Blinkinlabs/HopeBadge/README.md

# HOPE Badge
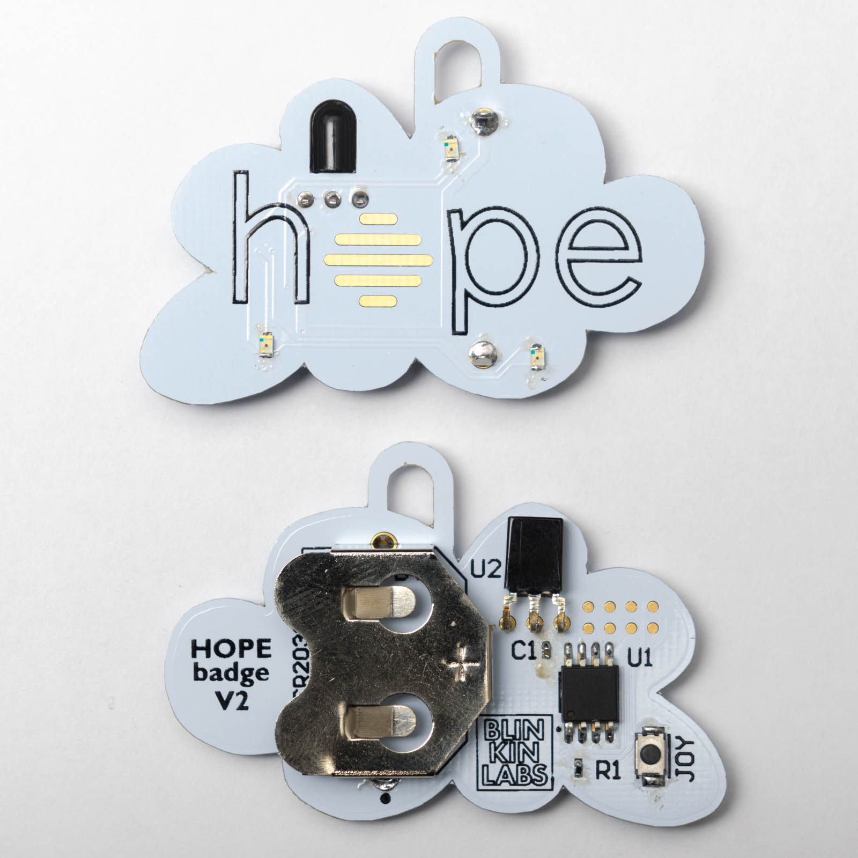
[picture p1: documentation/blinky.jpg]


HOPE Badge, Copyright 2017 Blinkinlabs, LLC

# License

This badge design is proprietary, contact us for usage.
