Blinkinlabs/HopeBadge/releases/2017-06-02 HopeBadge RevC.step

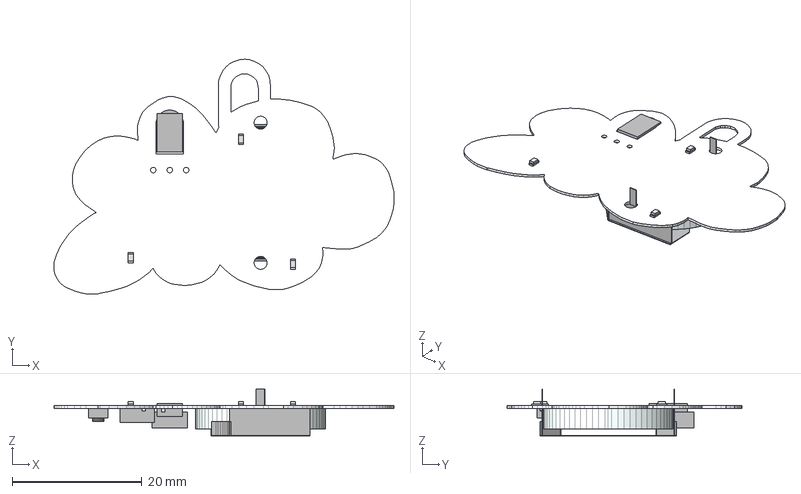
[picture p2: CAD file, 2018-05-12]
releases/2017-06-02 HopeBadge RevC.step
52.4 x 36.2 x 7.24 mm
Board
Extruded x 21
Mid_Body
Open_CASCADE_STEP_translator_6.8_2.2.1 x 2
Mark
