Blinkinlabs/HopeBadge/releases/2017-06-02 HopeBadge RevC.PDF

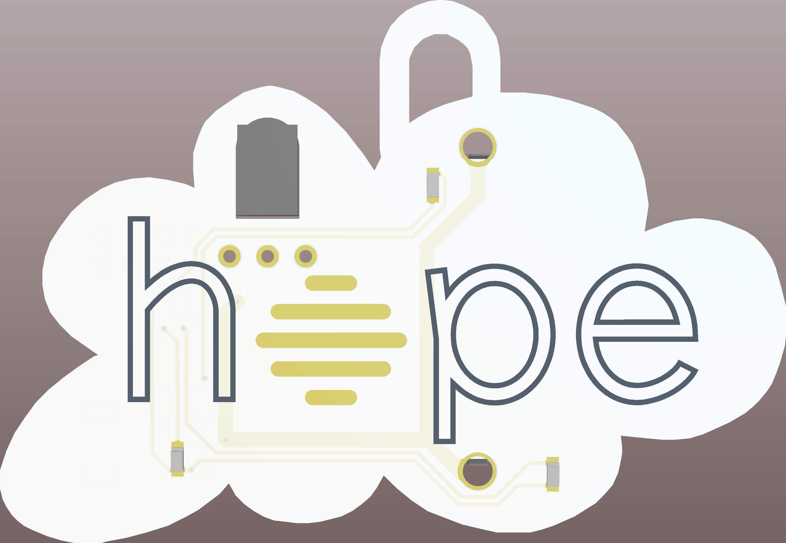
[picture p3: page 1]

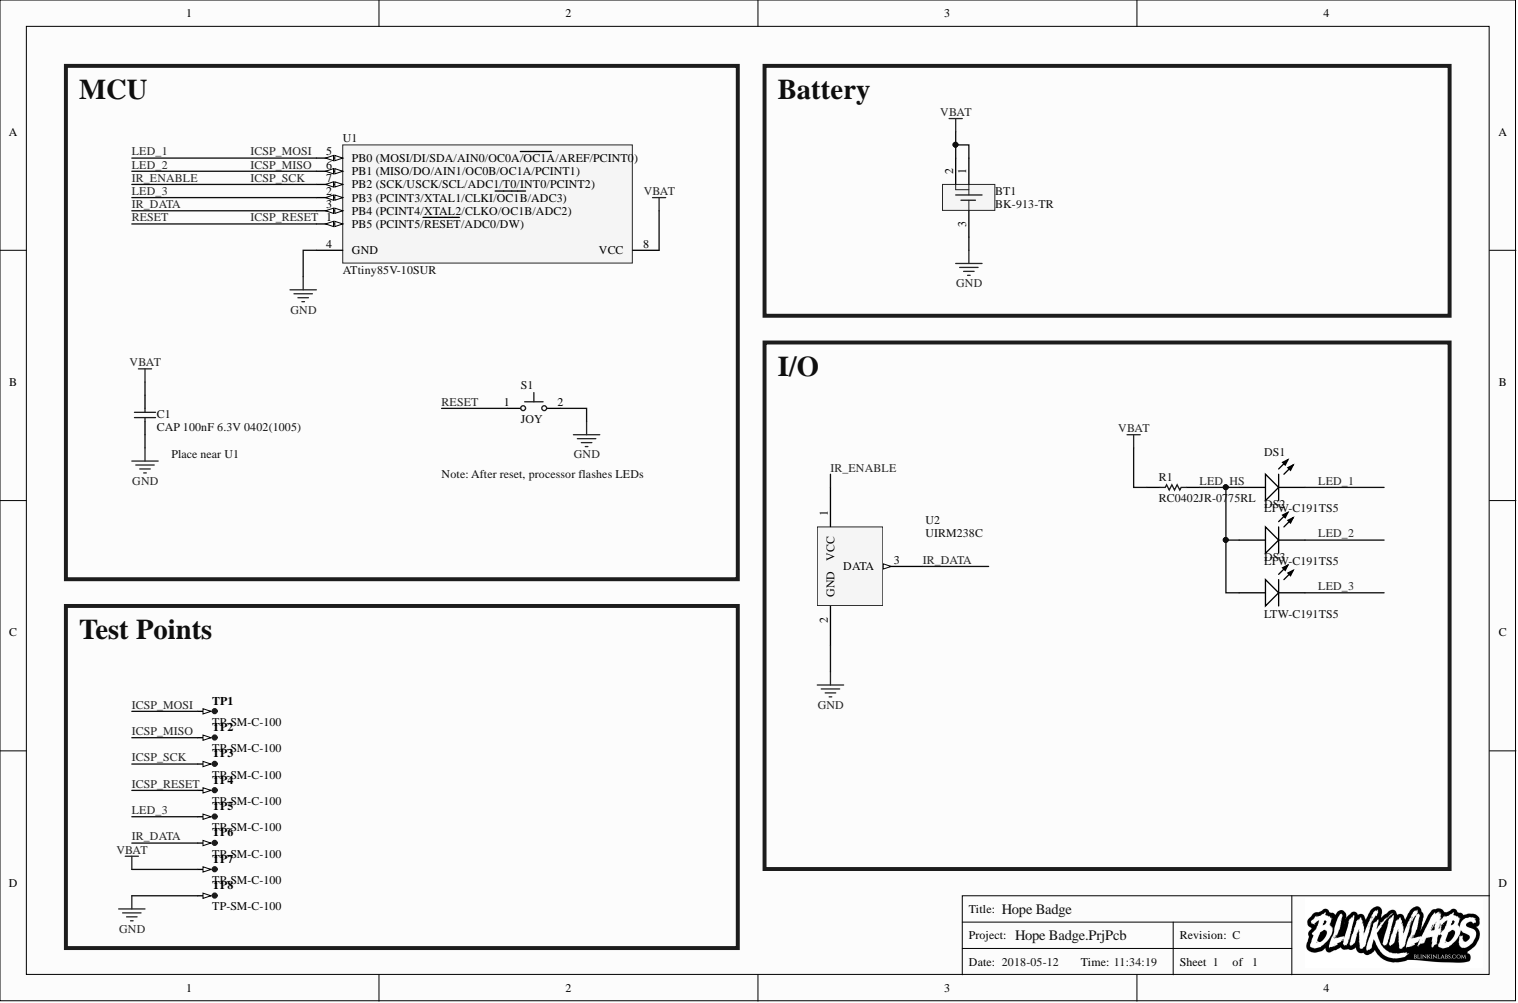
[picture p4: page 2]

Note: After reset, processor flashes LEDs

Title: Hope Badge

Project: Hope Badge.PrjPcb | Revision: C

Date: 2018-05-12 Time: 11:34:19 | Sheet 1 of 1

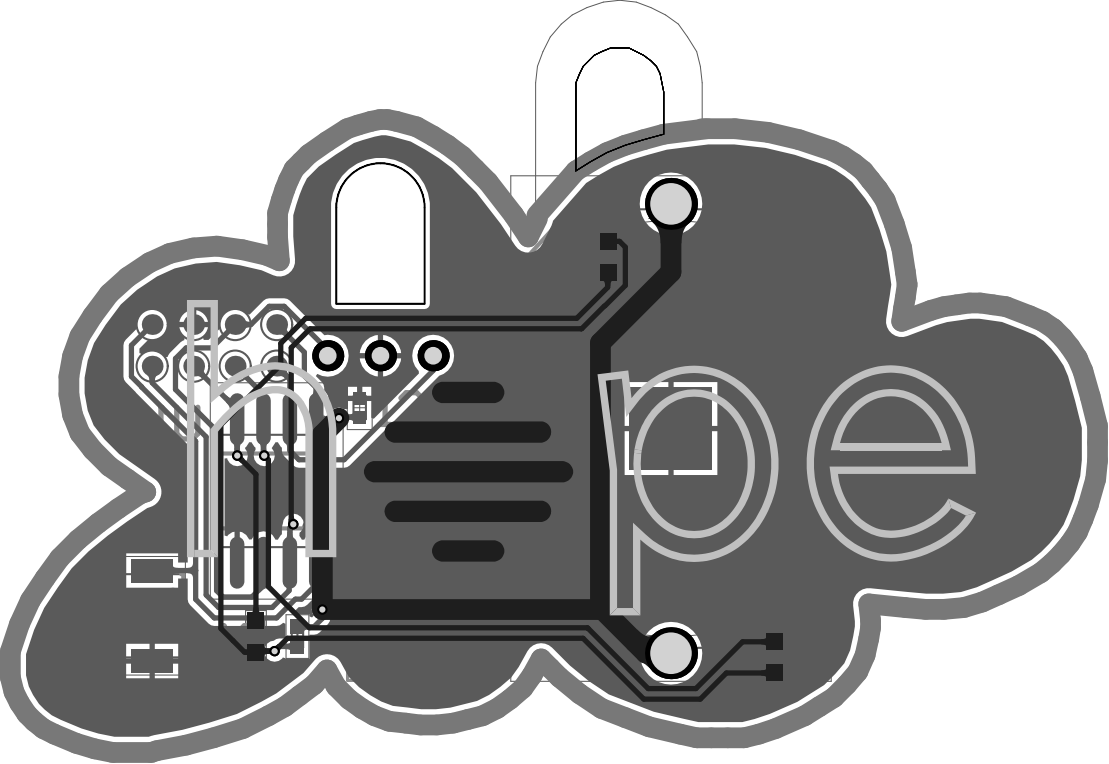
[picture p5: page 3]

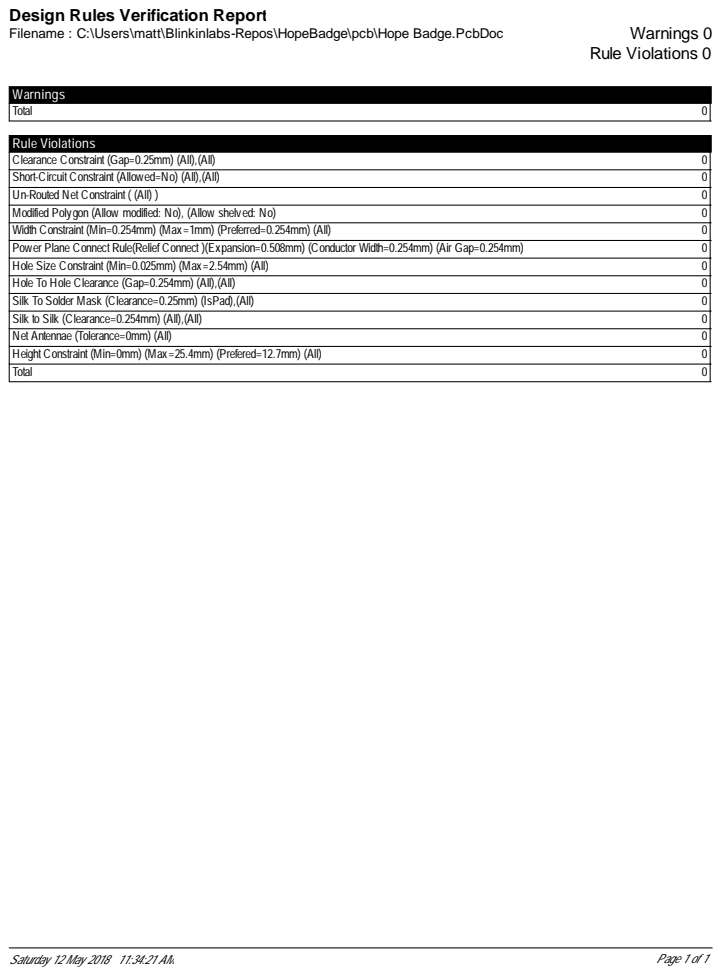
[picture p6: page 4]

Design Rules Verification Report

### Electrical Rules Check Report

Class | Document | Message
Warning | Hope Badge.SchDoc | ICSP_SCK contains IO Pin and Power Pin objects (Pin U2-1,Pin U1-7)
Warning | Hope Badge.SchDoc | IR_DATA contains IO Pin and Output Pin objects (Pin U1-3,Pin U2-3)
Warning | Hope Badge.SchDoc | Nets Wire ICSP_MISO has multiple names (Net Label ICSP_MISO,Net Label
| | ICSP_MISO,Net Label LED_2,Net Label LED_2)
Warning | Hope Badge.SchDoc | Nets Wire ICSP_MOSI has multiple names (Net Label ICSP_MOSI,Net Label
| | ICSP_MOSI,Net Label LED_1,Net Label LED_1)
Warning | Hope Badge.SchDoc | Nets Wire ICSP_RESET has multiple names (Net Label ICSP_RESET,Net Label
| | ICSP_RESET,Net Label RESET,Net Label RESET)
Warning | Hope Badge.SchDoc | Nets Wire ICSP_SCK has multiple names (Net Label ICSP_SCK,Net Label ICSP_SCK,Net
| | Label IR_ENABLE,Net Label IR_ENABLE)
Saturday 12 May 2018 11:34:22 AM | Page 1 of 1

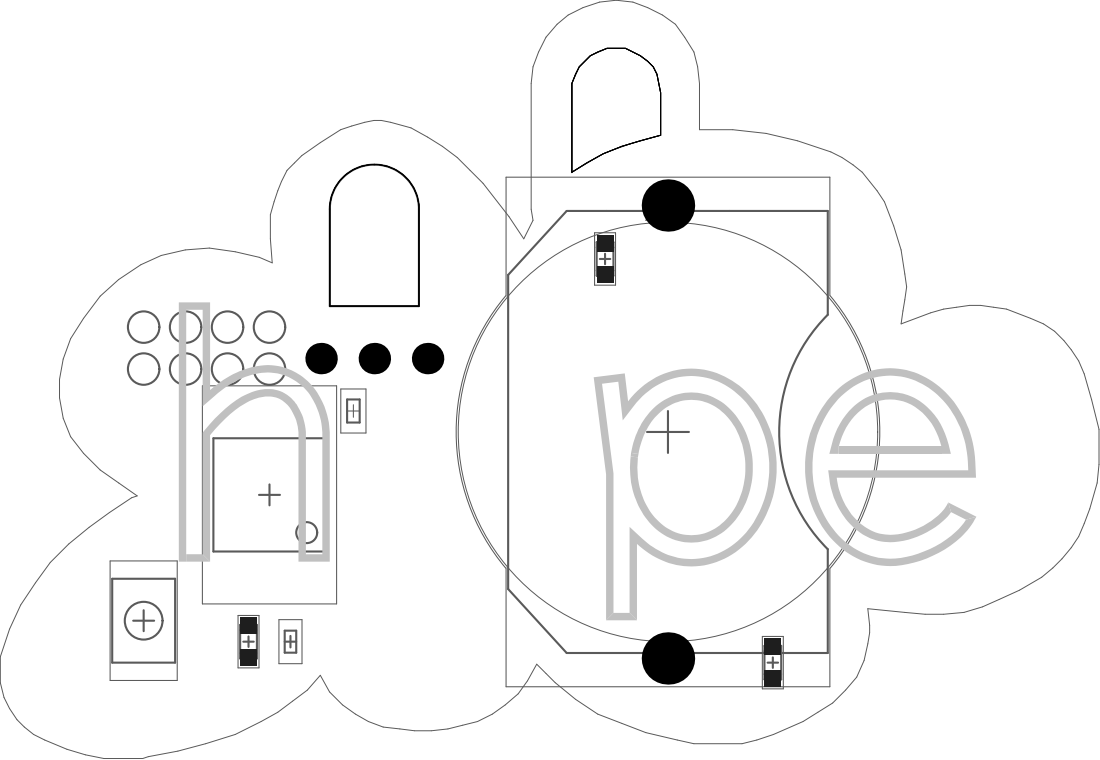
[picture p7: page 6]

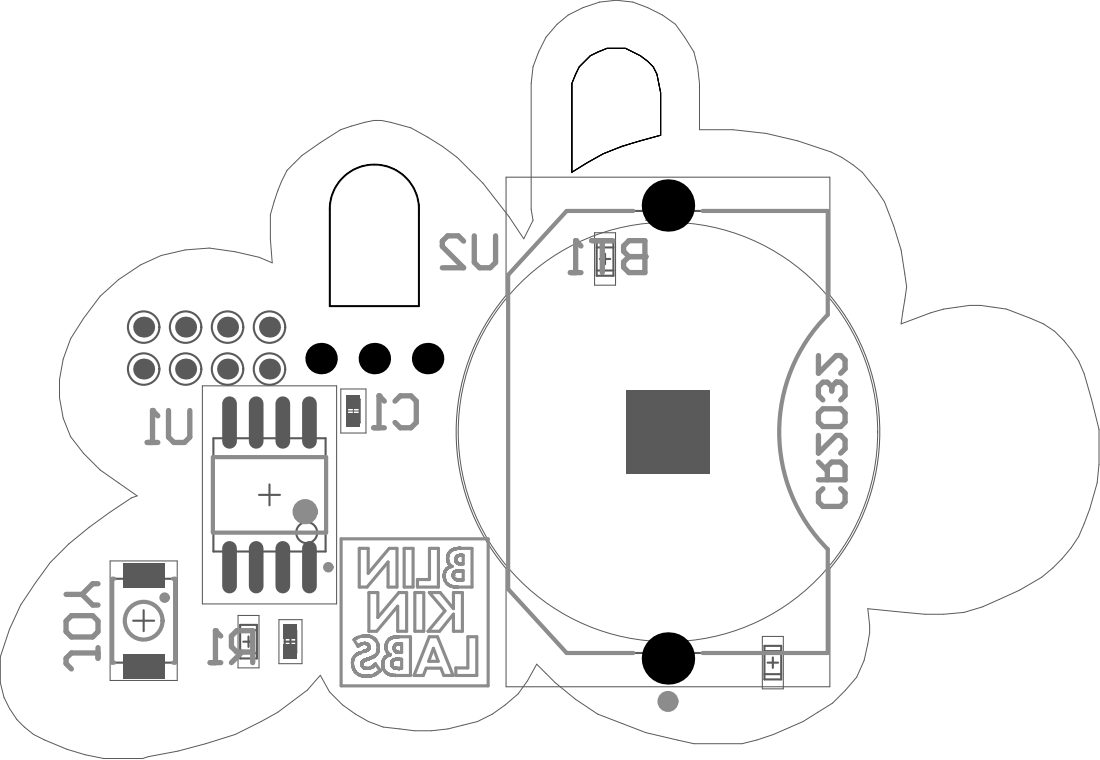
[picture p8: page 7]
