Blinkinlabs/HopeBadge/(list of files, drawings)

Other design files:
pcb/Hope Badge.PcbDoc
pcb/Hope Badge.PrjPcb
pcb/Hope Badge.SchDoc
