Blinkinlabs/HopeBadge/(commit log)

2017-05-27 LED flasher firmware
2017-06-02 Switch to attiny25
2017-06-11 Add board design
    [Hope Badge.PcbDoc, Hope Badge.PrjPcb, Hope Badge.SchDoc]
2017-06-11 Flash the LEDs if an external reset caused the device to reset
    [hopebadge.c, hopebadge.h]
2017-06-12 Switch to count-based IR detector
2017-06-12 Pull production files in from LeoBlinky
    [olimex-arm-usb-ocd-h-swapped.cfg]
2017-06-12 Test script that can program the fuses and the flash
2017-06-12 Switch to attiny25 target
2017-06-14 Add LED 3 test
2017-06-14 Increase acceptable current bands
2017-06-14 Avrdude: disable safemode (it doesn't help if the connection is bad)
    [avrdude.py, tests.py]
2018-05-12 Add updated release format
    [2017-06-02 HopeBadge RevC BOM.xls, 2017-06-02 HopeBadge RevC.step, Hope Badge.PcbDoc, Hope Badge.SchDoc]
